DerrickDarrell/Creality-K1-K1-Max/README.md

## CREALITY K1 / K1 MAX

-  All my mods for the K1 and K1 Max

**THE CONTENTS OF THIS REPOSITORY FALL UNDER:**
brave_DIrfEC1gKB
