DerrickDarrell/Creality-K1-K1-Max/Knomi Cover-Shroud/README.md

# K1 & K1 Max Knomi Cover/Shroud


# INTRODUCTION
Working on some fixes for the V2 Shroud

This is basically my original shroud except the blower has been lowered, added a mounting area for the Knomi and replaced the spring retainer on the carriage so you don't have to break off the USB-C port. I kept is as compact and as close to the original size as possible.

The Knomi and the shroud have a slight interference fit. Depending on how well your printer is tuned it should have a snug fit. You will also need to print the replacement spring retainer so the USB-C port fits (V1 only) and the guitar looking thingy that holds the Knomi in place with a M3x6mm BHCS screw.

Use the free port labeled 'FILAMENT' in the back of the toolhead PCB (pictured) to power the Knomi. Red wire coming from Knomi goes to 'V', black wire goes to 'G'.

After installing Knomi, please check BTT's github for further instructions

https://github.com/bigtreetech/KNOMI

If you like my work consider [buying me a ko-fi](https://ko-fi.com/derrickdarrell) ☕😊 Your support is greatly appreciated.

# IMPORTANT
- I have not tested the V2 shroud. If you run into any issues, please let me know
- The V2 shroud does not require the modified spring retainer

# BOM
- MX1.25-3pin
- M3x6mm BHCS Screw

# LAST UPDATED: Jan 27, 2024
- Extra space in the spring retainer for Lidar cable

# PRINT SETTINGS
- ABS or better
- Upright
- Supports needed
- 0.15-0.2 layer height



d66w

## All my work is protected under the **Attribution-NonCommercial-ShareAlike 4.0 International (CC BY-NC-SA 4.0)** license
