DerrickDarrell/Creality-K1-K1-Max/K1 Wide Stance Legs-Feet/README.md

# K1 Wide Stance Legs/Feet


## INTRODUCTION

I have a heavility modified K1 called [The AWD K1VZ](https://www.youtube.com/watch?v=dlzfl8IJW0U) and got tired of having to hold down the printer to keep it from hopping all over the place at high speeds.. So I made these.
They've made a huge difference.

The lip these legs mount to are not the same thickness in all K1's so I added a few different clearances. Measure the lip the bottom panel screws into. I recommend printing the test pieces to verify fitment so you know which legs you need. Fitment needs to be tight but not impossible to install 😐

There is also two different versions. One that use the threads on the frame or if for some reason yours are damaged, you can clean up the hole with a drill bit and use the clamp version. These will need a heat insert at the top of the leg for the M3x45mm BHCS to screw into.

If you like my work consider [buying me a ko-fi](https://ko-fi.com/derrickdarrell) ☕😊 Your support is greatly appreciated.

Latest video using these legs - [YouTube](https://www.youtube.com/shorts/MX2oaUfnXk0)

## IMPORTANT

1. Consider this a WORK IN PROGRESS
2. You are downloading/installing this mod willingly
3. I am not responsible/liable for any damage caused
4. Just because it fixed my issues/helped me, it does not mean it will do the same for you
5. You will not be able to mount the bottom metal panel after installation
6. You will need to recolate the MB Fan (check out Henlor's Fan mod)
7. These have not been tested in the K1 Max

## BOM
- x4 - M3x45mm BHCS screws
- x4 - M3x4x5mm Heat Inserts (to attach rubber feet)
- x8 - M3x4x5mm Heat Inserts (if using clamp version)

## LAST UPDATED:

## PRINT SETTINGS

The stronger, the better. Up to you. Any feedback on settings used & rigidity is appreciated

Settings I used (too much?)
- Layer Height: 0.2
- 6 Walls/Top/Bottom
- Infill: 60% Cubic
- No supports needed

## USEFUL LINKS

[How to use heat inserts](https://ultimaker.com/learn/how-to-use-heat-set-inserts-to-securely-fasten-3d-printed-parts/)

## OTHER RECOMMENDED MODS

[Henlor's Fan Mount mod](https://www.printables.com/model/540070-motherboard-fan-mount-mk2-collection-creality-k1-s)

## INSTRUCTIONS

1. Install heat inserts on the bottom of the legs to hold the rubber feet
   - If using the clamp version of the legs, you will need to install heat inserts at the top of the legs too
2. Remove bottom panel
3. Slide legs into the corners till the holes align 
4. Install MB cooling fan using recommended mod
5. Enjoy
