DerrickDarrell/Creality-K1-K1-Max/K1 Side Braces/README.md

# K1 SIDE BRACES

300223062-4206561b-92dc-4dd4-9215-494771ae762e

# INTRODUCTION

I made these braces to strengthen the frame in the K1 3D printer.

From my previous versions I found out the panel likes to rattle against the printed part in the areas between the screws. You will need 1mm foam tape to prevent the panel rattling on the plastic (pictured)

If you like my work consider [buying me a ko-fi](https://ko-fi.com/derrickdarrell) ☕😊 Your support is greatly appreciated.

k1-braces-2024-01-27-165018
Side Braces-2024-06-01 000228

# IMPORTANT
- Still testing
- I take no responsibility if you damage your machine or whatever worse may come of that
- Will not work with custom hinges (e.g., 270°)

# BOM
- M3x18mm screws (outer perimeter)
- 4x - M3x10mm BHCS screws
- 4x - M3 hex nuts
- 1mm foam tape

# LAST UPDATED: June 1, 2024
- Will need 1mm foam tape to combat rattle between the mounting screws

# PRINT SETTINGS
-The stronger the better. Any feedback is appreciated

## All my work is protected under the **Attribution-NonCommercial-ShareAlike 4.0 International (CC BY-NC-SA 4.0)** license
