DerrickDarrell/Creality-K1-K1-Max/Gantry V2.0/README.md

# K1 Gantry V2.0

ezgif-3-a89995acc8



## INTRODUCTION
Main reason for the creation of this mod was to fix the issue of the gantry not being square in my machine throwing off the mesh. It has since fixed the "unlevel" or "warped" bed and has also resulted in quieter operation of the printer. Having a custom gantry also opens the door to future upgrades/mods. These mounts have gone through weeks of testing and have proven to be more than capable of handling the K1. 

With the V2 Gantry, replacing the factory steppers and 36t timing gears resulted in a massive drop in vibrations in the gantry. Moving the belt tensioners to the front idler mounts has also made it much easier to tension the belts and fixed the issue of the factory tensioner buckling in the factory stepper mounts.

If you like my work consider [buying me a ko-fi](https://ko-fi.com/derrickdarrell) ☕😊 Your support is greatly appreciated.

6:16 Benchy using V2 Gantry - [YouTube](https://www.youtube.com/watch?v=GfOL87u7CSw&ab_channel=DerrickDarrell)

## IMPORTANT
 
 1. Consider this a WORK IN PROGRESS
 2. You are downloading/installing this mod willingly
 3. We are not reponsible/liable for any damage caused
 4. Do not use heat inserts shorter than the recommended
 5. Just because it fixed my issues it does not mean it will fix yours
 6. This mod does not use factory steppers or hardware
 7. The 20T timing gears are 20mm tall
 8. You will need to change the rotation distance accordingly (40 for 20T Timing Gear)
 9. You will need to tune sensorless homing
 10. Will not work with factory door hinges (check 'USEFUL LINKS')
 11. Not 100% compatible with the FatBoy joints. Belts touch the housing slightly. I recommend sticking with Omran's regular joints (V3.1-3.3)

## BOM

- x8 - 16T Toothless 3mm Bore pulleys 8.5x13mm (see pictures)
- x2 - 20T Timing Gear (see pictures)
- x18 - M3x6x5mm Heat Inserts (frame)
- x2 - M3x4x5mm Heat Inserts (belt tensioners)
- x16 - M3x8mm FHCS Screws (frame)
- x2 - M3x10mm FHCS Screws (frame)
- x4 - M5x5mm Grub Screws (Y rods)
- M3 Washers
- x4 - M3x6mm BHCS Screws
- x4 - M3x8mm SHCS Screws
- x2 - M3x20mm BHCS Screws
- x2 - M3x20mm SHCS Screws
- x2 - M3x30mm SHCS Screws
- x2 - M3x35mm SHCS Screws

279499338-70331970-2a5b-4686-95f6-08eb57c7ec31

## LAST UPDATED:
-

## PRINT SETTINGS

- ABS or better
- Supports needed (stepper mounts only)
   - Tree
   - Top Z distance: 0
   - Top interface layers ON
- Layer Height: 0.2
- Layer Width: 0.4
- Wall Loops: 5 (minimum)
- Top/Bottom Layers: 5 (minimum)
- Infill: 50% (minimum)
- Brim
- Tensioner/Pulley Holder: 100%

Screenshot (82)

## USEFUL LINKS

[How to use heat inserts](https://ultimaker.com/learn/how-to-use-heat-set-inserts-to-securely-fasten-3d-printed-parts/)

[270° Door Hinges](https://www.printables.com/model/526107-creality-k1-270deg-door-hinges-w-door-latch)

[Tune Sensorless Homing](https://www.klipper3d.org/TMC_Drivers.html?h=sensorless#sensorless-homing)

## OTHER RECOMMENDED MODS

- [Omranello's XY Joints](https://github.com/D3vil-Design/K1-Hardware-Mods/tree/main/K1%20XY%20joints%20V3.1)

- [Knomi Shroud](https://makerworld.com/en/models/179287)

## INSTRUCTIONS

- Rigidity is important. Print the mounts using the recommended print settings or better
- Push the heat-set inserts into place as straight as possible or you will end up with alignment issues with the holes in the frame
- Make sure the inserts sit flush and that you don't heat the surrounding plastic more than necessary
- The stepper motors need to be screwed into the mounts before the pulleys
- Use M5x5mm grub screws to hold the Y axis rods on all mounts
- Snug the Y rod grub screws after installing the gantry in the printer

Untitled design (1)



## All my work is protected under the **Attribution-NonCommercial-ShareAlike 4.0 International (CC BY-NC-SA 4.0)** license
