DerrickDarrell/Creality-K1-K1-Max/5015 Bed Fans/README.md

# 5015 Bed Fans

274795451-fd37e89d-60dc-441f-81ba-99080f510d08

275111557-0f33dc44-539e-4d77-9d3f-4eb2ba4c735f

## INTRODUCTION
I made this mod to help with heating the enclosure. It uses one or two 5015 24V blowers. I have the fans wired in parallel using the exhaust fan port since I don't use it (up to you). These bed fans were tested using an AC bed (110V, 500W) and the printer completely sealed. The bed fans can work with the factory bed/bed heater but it won't be as effective. 

If you like my work consider [buying me a ko-fi](https://ko-fi.com/derrickdarrell) ☕😊 Your support is greatly appreciated.

## IMPORTANT
 
 1. Consider this a WORK IN PROGRESS
 2. You are downloading/installing this mod willingly
 3. We are not reponsible/liable for any damage caused
 4. This mod was tested with an aftermarket bed/bed heater
 5. Keep wires away from the Z belt in the bottom compartment
 6. Fan Mounts need 8mm of clearance under the bed/bed heater
 7. Fan mounts might not be compatible with some screen hole sealers
 8. Have not been tested in the K1 Max. I don't see a reason why they wouldn't work

## BOM

-  4x M3x20mm Screws (fans)
-  4x M3x12mm Screws (mount/sensor)
-  4x M3 Hex Nuts (fans)
-  1x Male 2.54mm JST-XH connector (for fan header)
-  22-24AWG wire

# PRINT SETTINGS

-  ABS or better
-  4 walls, 4 top/bottom, 25% infill (or better)
-  Supporters needed (external only)

## USEFUL LINKS

# INSTRUCTIONS

1. Remove the four M4 (or M5 🤨) screws holding the bed plate down (pictured below)
2. Remove the front 4 M3x6mm screws on the pressure sensor
3. Mount the brackets using M3x20mm screws
4. Solder the fan cables into a Y-splitter (parallel)
5. Run the cable down with the rest of the harness into the bottom compartment

274795503-561e1705-618d-4e95-8970-a52c895d2995

274795514-c6e35c3a-ef63-488c-aff9-8c79a844c0c7

## All my work is protected under the **Attribution-NonCommercial-ShareAlike 4.0 International (CC BY-NC-SA 4.0)** license
