DerrickDarrell/Creality-K1-K1-Max/5015 Bed Fans/STL Files/K1 5015 Bed Fan Mount Single.stl

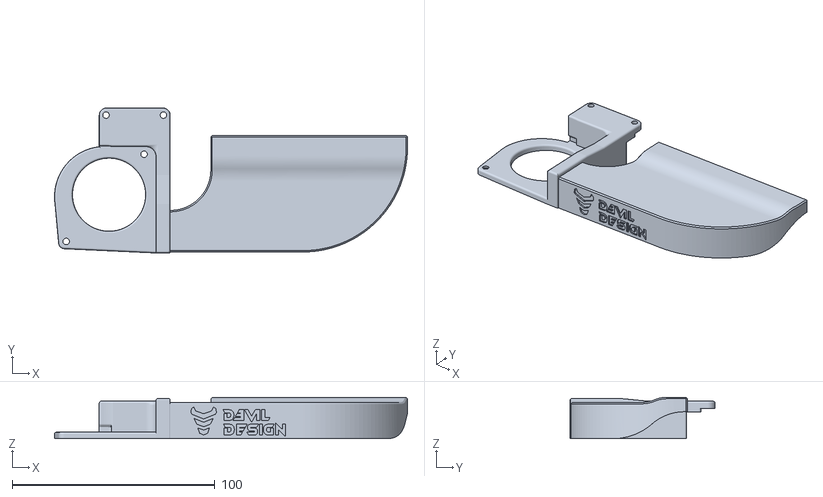
[picture p1: CAD file, 2024-01-25]
5015 Bed Fans/STL Files/K1 5015 Bed Fan Mount Single.stl
174.1 x 71.5 x 20.4
