DerrickDarrell/Creality-K1-K1-Max/Gantry V2.0/STEP Files/Idler Mounts & Tensioners.step

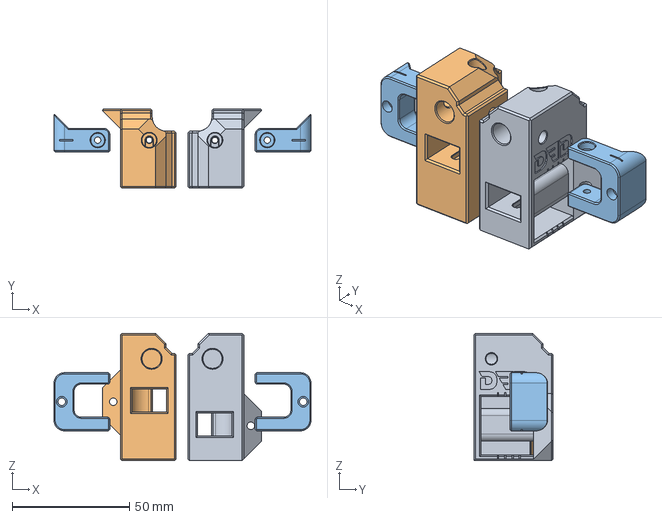
[picture p2: CAD file, 2024-03-19]
Gantry V2.0/STEP Files/Idler Mounts & Tensioners.step
109.6 x 33.8 x 54.3 mm
