DerrickDarrell/Creality-K1-K1-Max/Gantry V2.0/STL Files/Front Left Idler & Tensioner V2.stl

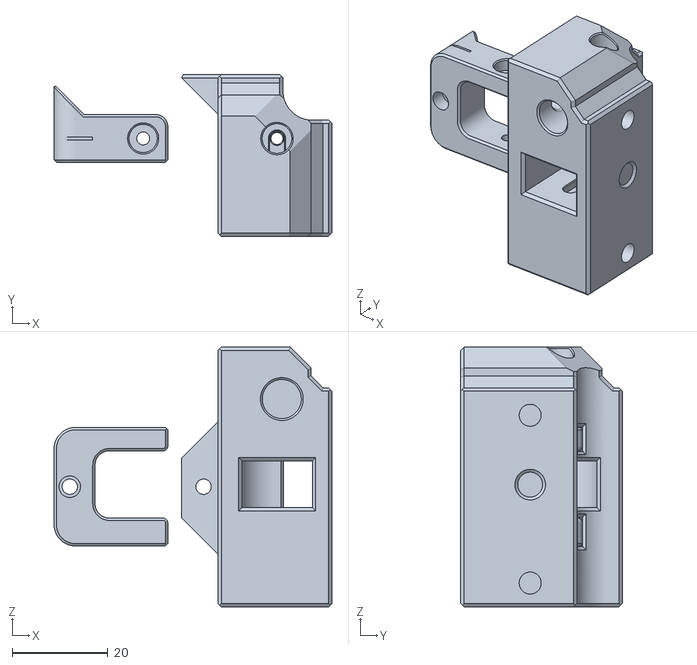
[picture p3: CAD file, 2024-01-25]
Gantry V2.0/STL Files/Front Left Idler & Tensioner V2.stl
58.1 x 33.8 x 54.3
