DerrickDarrell/Creality-K1-K1-Max/K1 Side Braces/STL Files/Bottom Right.stl

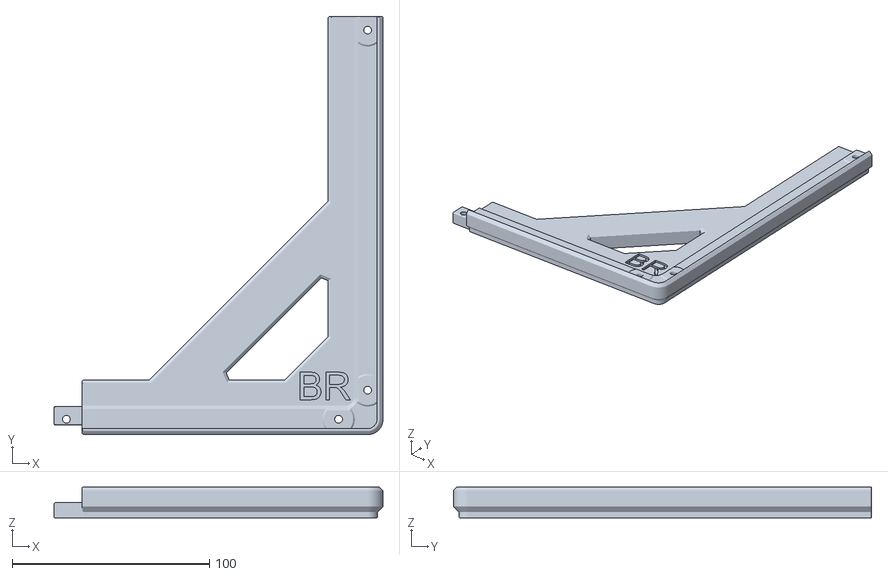
[picture p4: CAD file, 2024-06-01]
K1 Side Braces/STL Files/Bottom Right.stl
167.0 x 212.3 x 15.7
