DerrickDarrell/Creality-K1-K1-Max/K1 Wide Stance Legs-Feet/K1 Legs 2.8mm.3mf

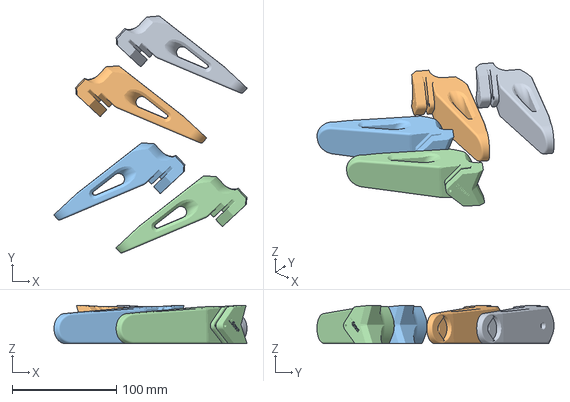
[picture p5: CAD file, 2024-02-12]
K1 Wide Stance Legs-Feet/K1 Legs 2.8mm.3mf
185.4 x 227.7 x 36.6 mm
leg 2.8.stl x 4
