DerrickDarrell/Creality-K1-K1-Max/Knomi Cover-Shroud/STEP Files/Knomi V1 Cover-Shroud.step

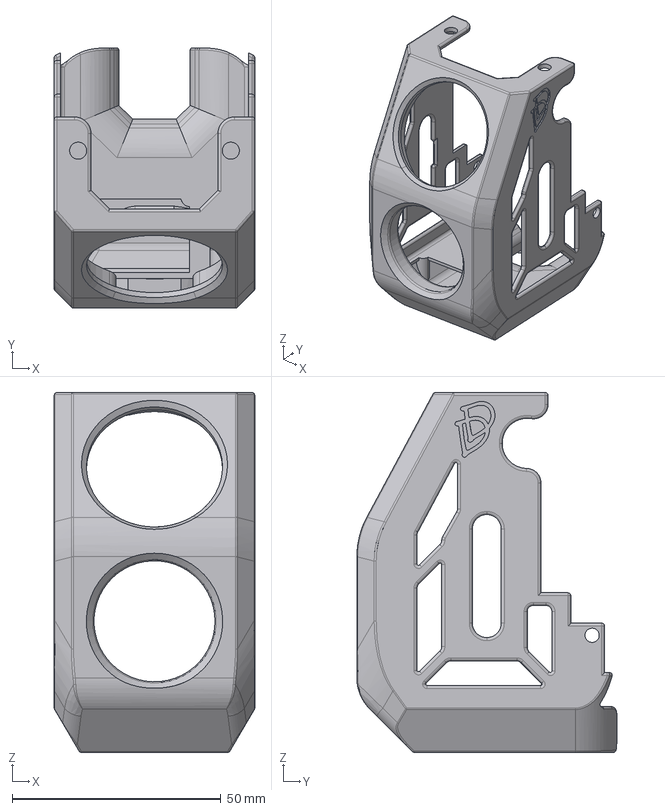
[picture p6: CAD file, 2024-03-19]
Knomi Cover-Shroud/STEP Files/Knomi V1 Cover-Shroud.step
48.1 x 62.4 x 86.3 mm
