DerrickDarrell/Creality-K1-K1-Max/Knomi Cover-Shroud/STL Files/Guitar pick looking thingy-thing.stl

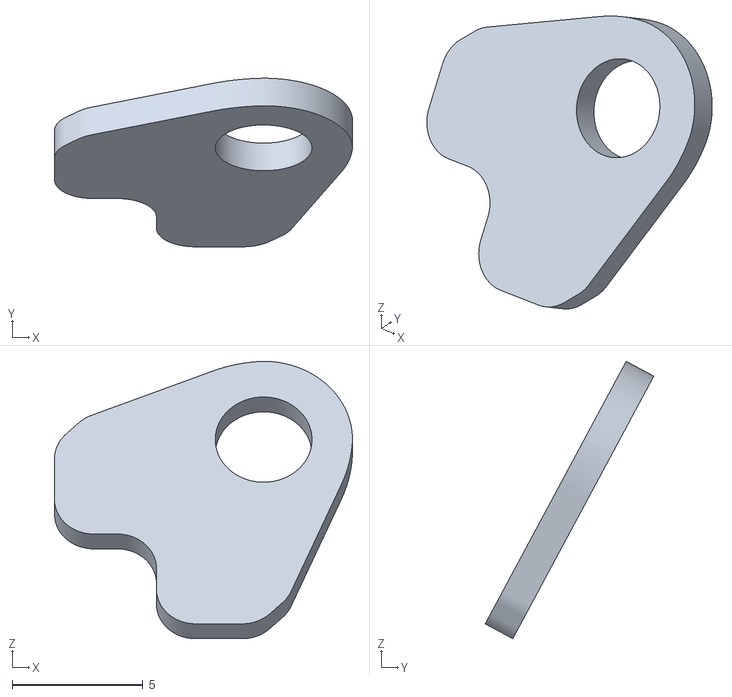
[picture p7: CAD file, 2024-01-26]
Knomi Cover-Shroud/STL Files/Guitar pick looking thingy-thing.stl
11.4 x 6.45 x 10.6
