DerrickDarrell/Creality-K1-K1-Max/TBGS-8mm Rods Concept Carriage/STL Files/K1 TBGS-8mm Rods Concept Joints.step

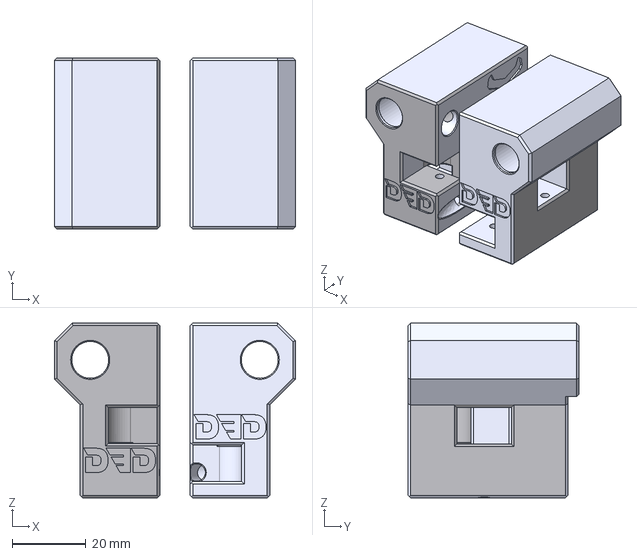
[picture p8: CAD file, 2024-01-25]
TBGS-8mm Rods Concept Carriage/STL Files/K1 TBGS-8mm Rods Concept Joints.step
65.4 x 46.5 x 47.5 mm
