DerrickDarrell/Creality-K1-K1-Max/Gantry V2.0/STEP Files/Left Stepper Mount V2.step

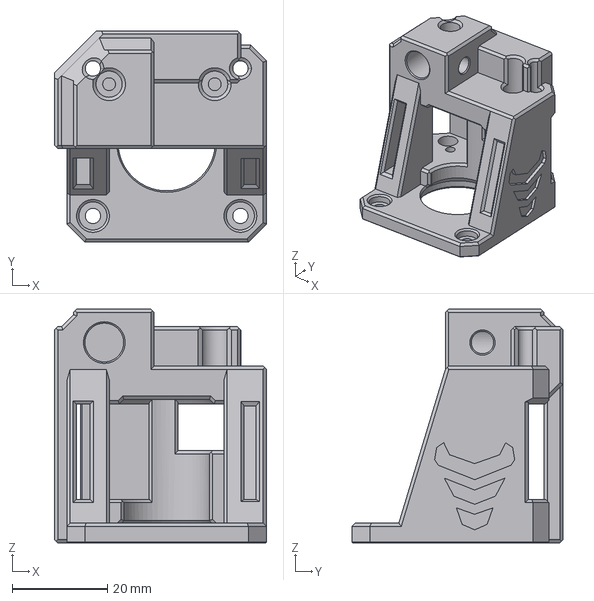
[picture p9: CAD file, 2024-03-19]
Gantry V2.0/STEP Files/Left Stepper Mount V2.step
44.6 x 44.4 x 49.2 mm
