DerrickDarrell/Creality-K1-K1-Max/Gantry V2.0/STL Files/Front Right Idler & Tensioner V2.stl

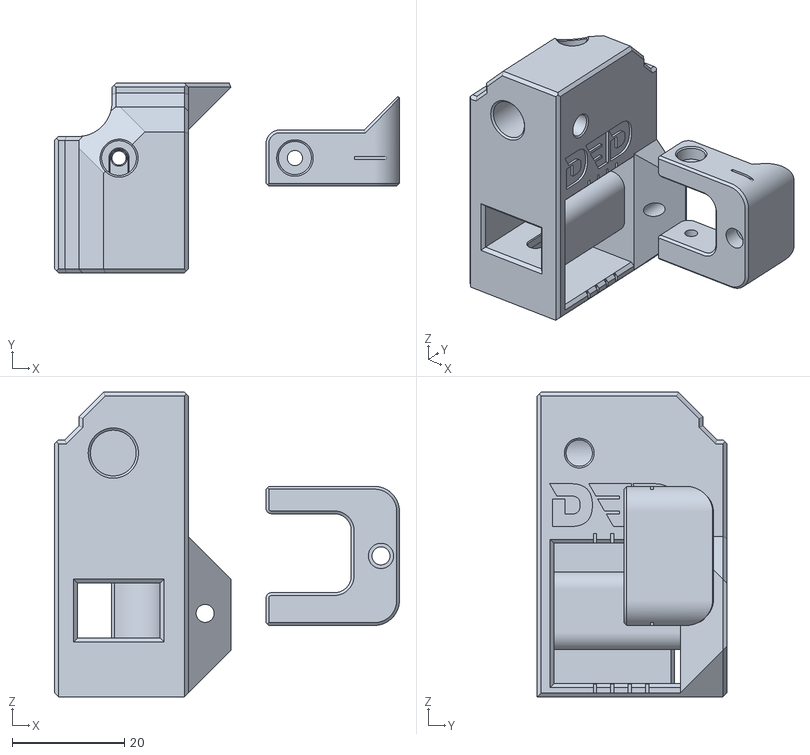
[picture p10: CAD file, 2024-01-25]
Gantry V2.0/STL Files/Front Right Idler & Tensioner V2.stl
61.5 x 33.8 x 54.3
