DerrickDarrell/Creality-K1-K1-Max/K1 Wide Stance Legs-Feet/K1 Legs Clamp 3.0mm.3mf

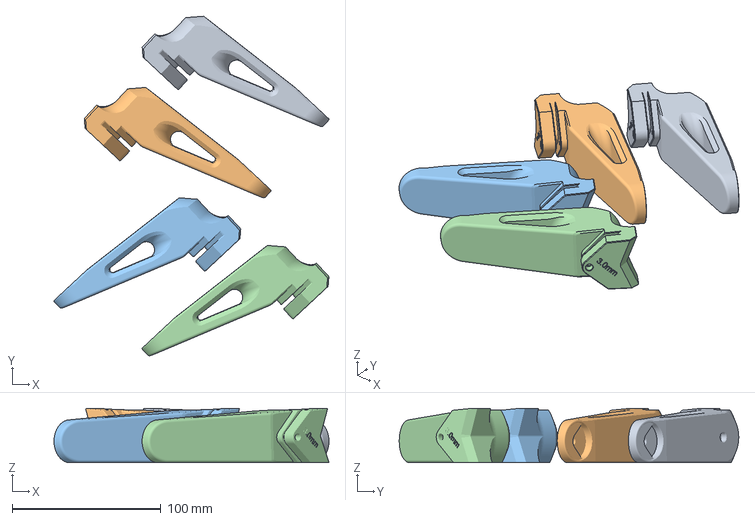
[picture p11: CAD file, 2024-02-12]
K1 Wide Stance Legs-Feet/K1 Legs Clamp 3.0mm.3mf
185.1 x 228.5 x 36.6 mm
leg clamp 3.0.stl x 4
