DerrickDarrell/Creality-K1-K1-Max/Knomi Cover-Shroud/STEP Files/Modified Spring Retainer.step

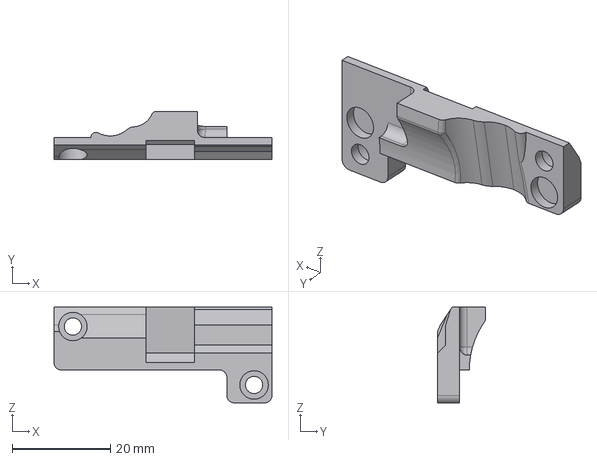
[picture p12: CAD file, 2024-03-19]
Knomi Cover-Shroud/STEP Files/Modified Spring Retainer.step
44.4 x 9.80 x 19.5 mm
