DerrickDarrell/Creality-K1-K1-Max/TBGS-8mm Rods Concept Carriage/STL Files/K1 TBGS-8mm Rods Concept Carriage.step

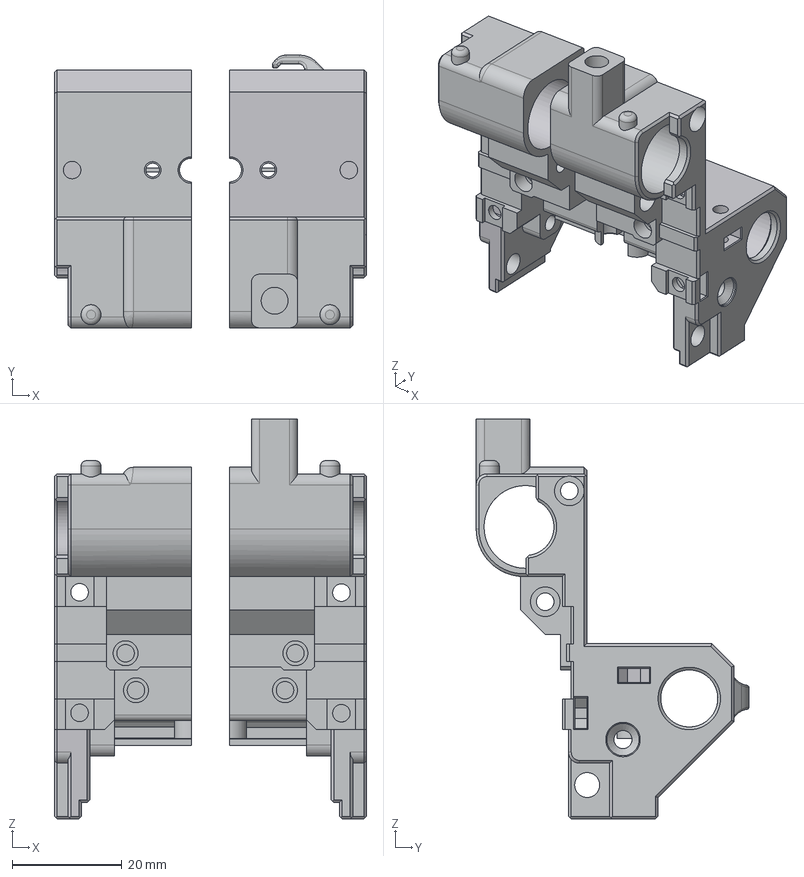
[picture p13: CAD file, 2024-01-25]
TBGS-8mm Rods Concept Carriage/STL Files/K1 TBGS-8mm Rods Concept Carriage.step
57.0 x 49.8 x 73.0 mm
