DerrickDarrell/Creality-K1-K1-Max/K1 Side Braces/STL Files/Top Right.stl

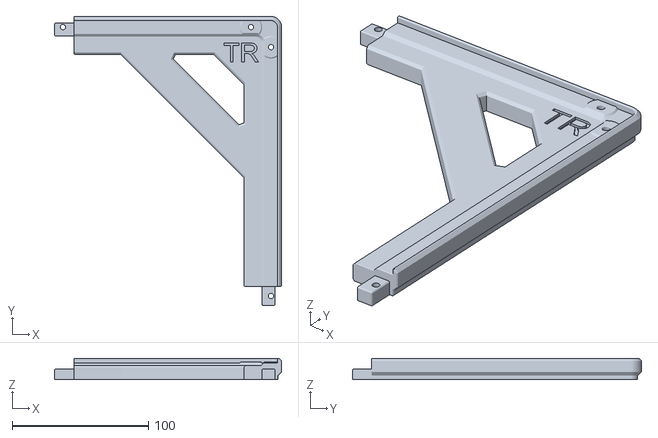
[picture p14: CAD file, 2024-06-01]
K1 Side Braces/STL Files/Top Right.stl
167.0 x 212.2 x 15.7
