DerrickDarrell/Creality-K1-K1-Max/K1 Side Braces/STL Files/Bottom Left.stl

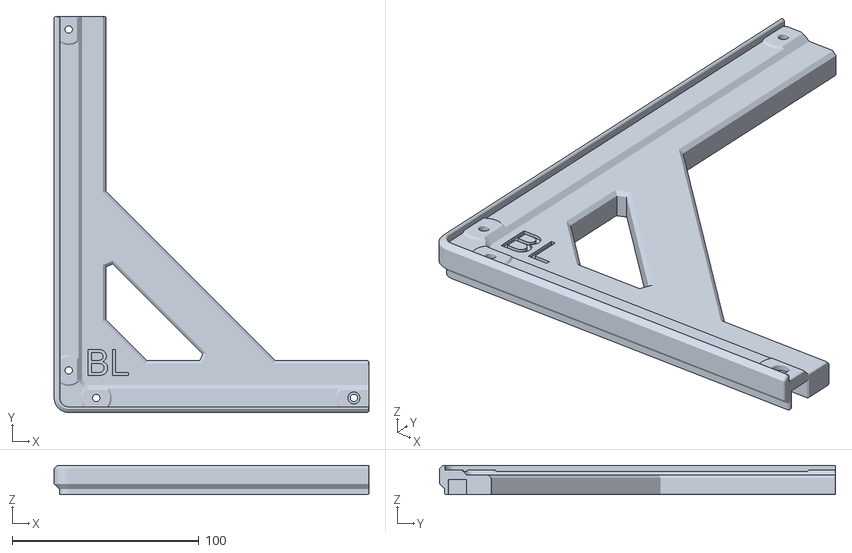
[picture p15: CAD file, 2024-06-01]
K1 Side Braces/STL Files/Bottom Left.stl
168.7 x 212.3 x 15.7
