DerrickDarrell/Creality-K1-K1-Max/K1 Wide Stance Legs-Feet/fitment test 2.6.stl

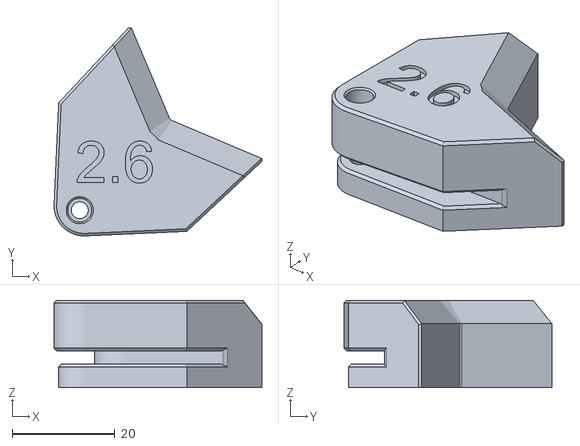
[picture p16: CAD file, 2024-02-12]
K1 Wide Stance Legs-Feet/fitment test 2.6.stl
40.4 x 40.4 x 16.9
