DerrickDarrell/Creality-K1-K1-Max/(list of files, cad)

Other CAD files:
K1 Side Braces/STL Files/Top Left.stl
Gantry V2.0/STEP Files/Right Stepper Mount V2.step
K1 Wide Stance Legs-Feet/K1 Legs Clamp 2.6mm.3mf
K1 Wide Stance Legs-Feet/K1 Legs 2.6mm.3mf
K1 Wide Stance Legs-Feet/fitment test 3.0.stl
K1 Wide Stance Legs-Feet/K1 Legs 3.0mm.3mf
K1 Wide Stance Legs-Feet/fitment test 2.8.stl
K1 Wide Stance Legs-Feet/K1 Legs Clamp 2.8mm.3mf
Gantry V2.0/STL Files/Left Stepper Mount V2.stl
Gantry V2.0/STL Files/Right Stepper Mount V2.stl
Knomi Cover-Shroud/STL Files/Modified Spring Retainer.stl
TBGS-8mm Rods Concept Carriage/STL Files/K1 TBGS-8mm Rods Concept Joints.stl
