DerrickDarrell/Creality-K1-K1-Max/(threads)

Thread 1 (2024-11-10):

access to your discord

Jegstrup, 2024-11-10:
hi i tried several of times to get into the discord also i wanna purchase the bom for the k1 z tilt but cant gain access to discord can you check if i ahve been blocked somehow i now for a long time ago i had som malware in my discord but it is fixed now

DerrickDarrell, 2024-11-11:
updated link, here you go
http://discord.gg/r5QzHBZ8SH

Thread 2 (2025-02-26):

Triple Z Klipper config

WayneManion, 2025-02-26:
I started on your triple-Z modification. I was wondering if you could share the relevant portions of your Klipper config. I'm mainly looking for this part I think:
```
[z_tilt]
#z_positions:
#   A list of X, Y coordinates (one per line; subsequent lines
#   indented) describing the location of each bed "pivot point". The
#   "pivot point" is the point where the bed attaches to the given Z
#   stepper. It is described using nozzle coordinates (the X, Y position
#   of the nozzle if it could move directly above the point). The
#   first entry corresponds to stepper_z, the second to stepper_z1,
#   the third to stepper_z2, etc. This parameter must be provided.
#points:
#   A list of X, Y coordinates (one per line; subsequent lines
#   indented) that should be probed during a Z_TILT_ADJUST command.
#   Specify coordinates of the nozzle and be sure the probe is above
#   the bed at the given nozzle coordinates. This parameter must be
#   provided.
#speed: 50
#   The speed (in mm/s) of non-probing moves during the calibration.
#   The default is 50.
#horizontal_move_z: 5
#   The height (in mm) that the head should be commanded to move to
#   just prior to starting a probe operation. The default is 5.
#retries: 0
#   Number of times to retry if the probed points aren't within
#   tolerance.
#retry_tolerance: 0
#   If retries are enabled then retry if largest and smallest probed
#   points differ more than retry_tolerance. Note the smallest unit of
#   change here would be a single step. However if you are probing
#   more points than steppers then you will likely have a fixed
#   minimum value for the range of probed points which you can learn
#   by observing command output.
```
Thanks.
